k0201/TiN_Anaalog_sensor_emulation/hardware/TiN_analog_sensor_emulation_front.png

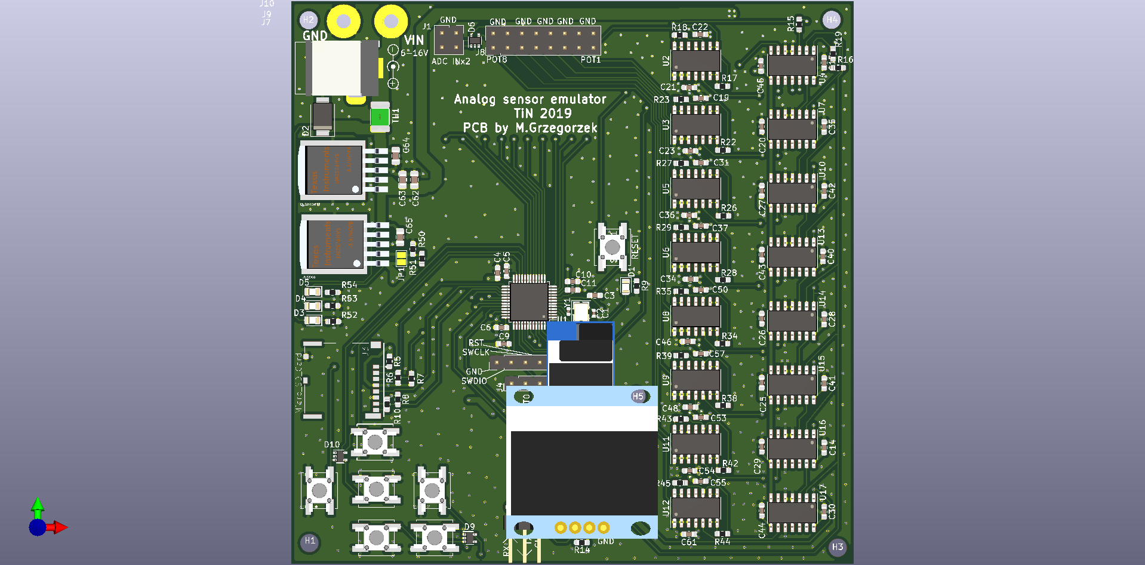
hardware/TiN_analog_sensor_emulation_front.png
