k0201/TiN_Anaalog_sensor_emulation/README.md

# TiN_Anaalog_sensor_emulation
Project for TiN at AGH 2019
