k0201/TiN_Anaalog_sensor_emulation/hardware/TiN_analog_sensor_emulation.pdf

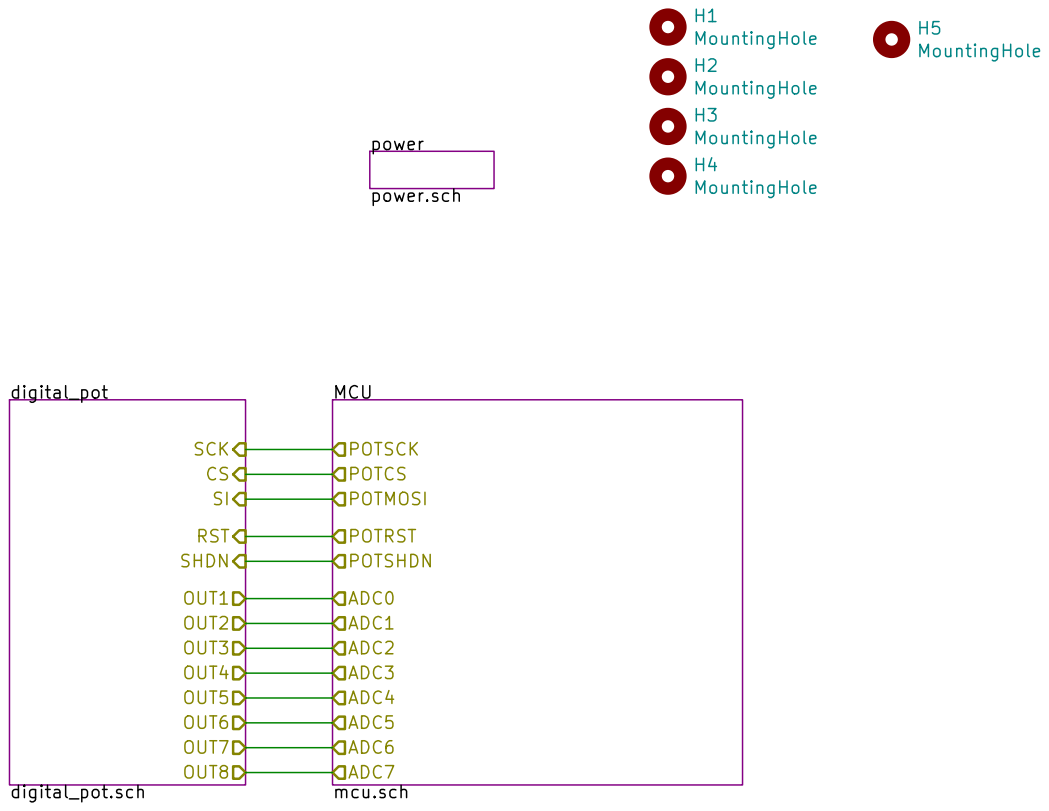
[picture p3: page 1]

MCU mcu.sch POTSCK
ADC0 ADC1 ADC2 ADC3 ADC4 ADC5 ADC7 ADC6 POTRST POTSHDN

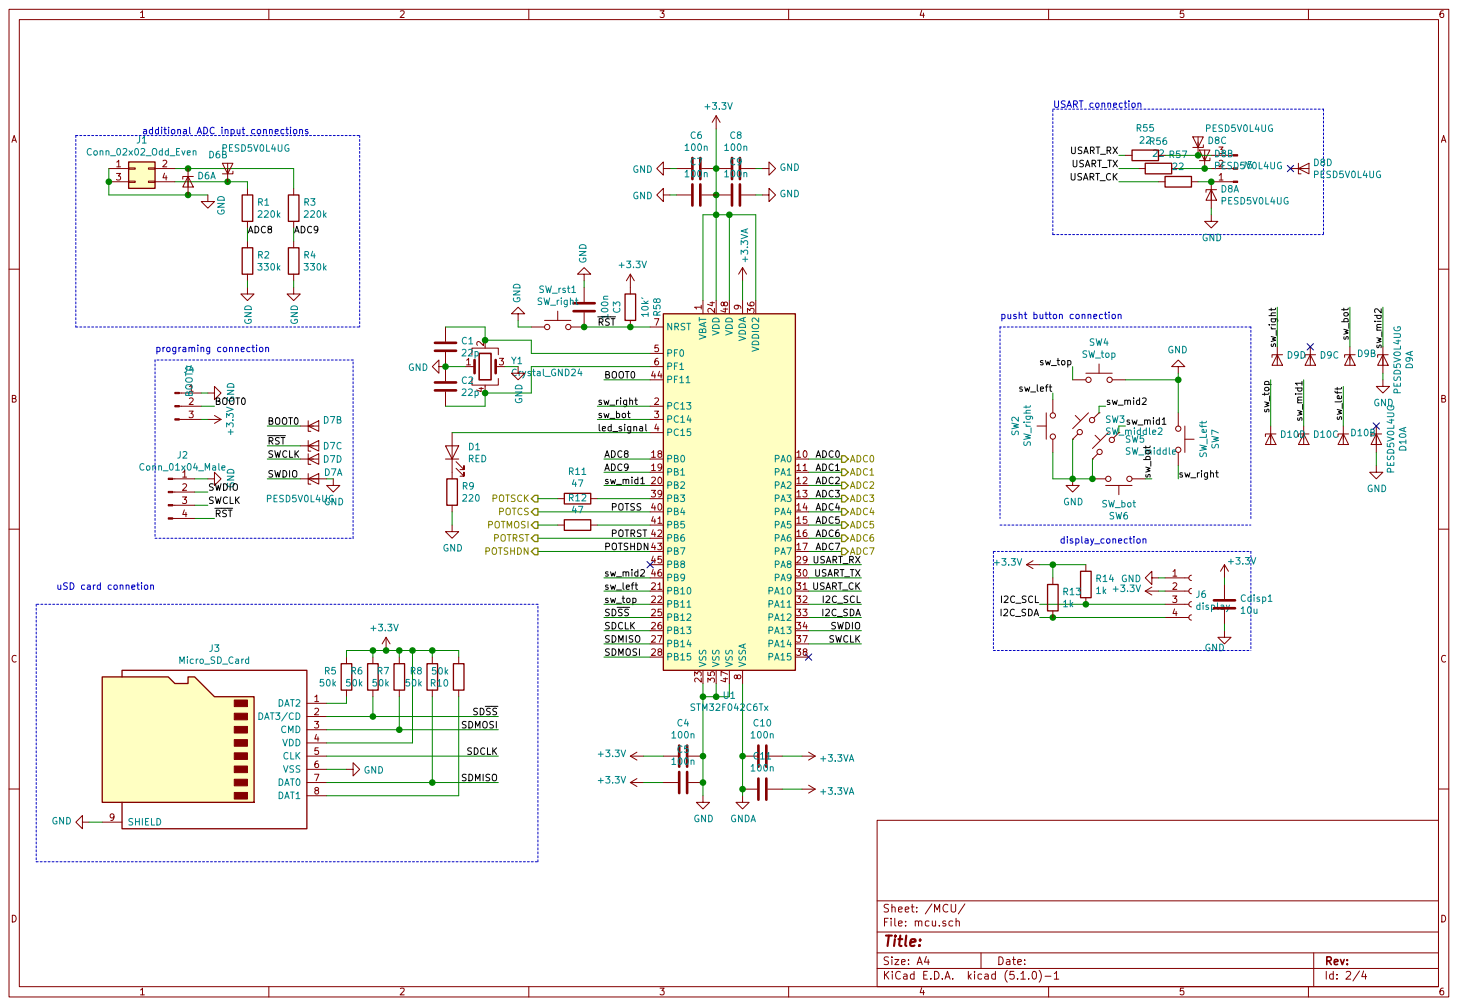
[picture p4: page 2]

additional ADC input connections D6BPESD5V0L4UG GND

9 VDDIO2 36 VSS 23 VSS 35 VSS 47 VSSA

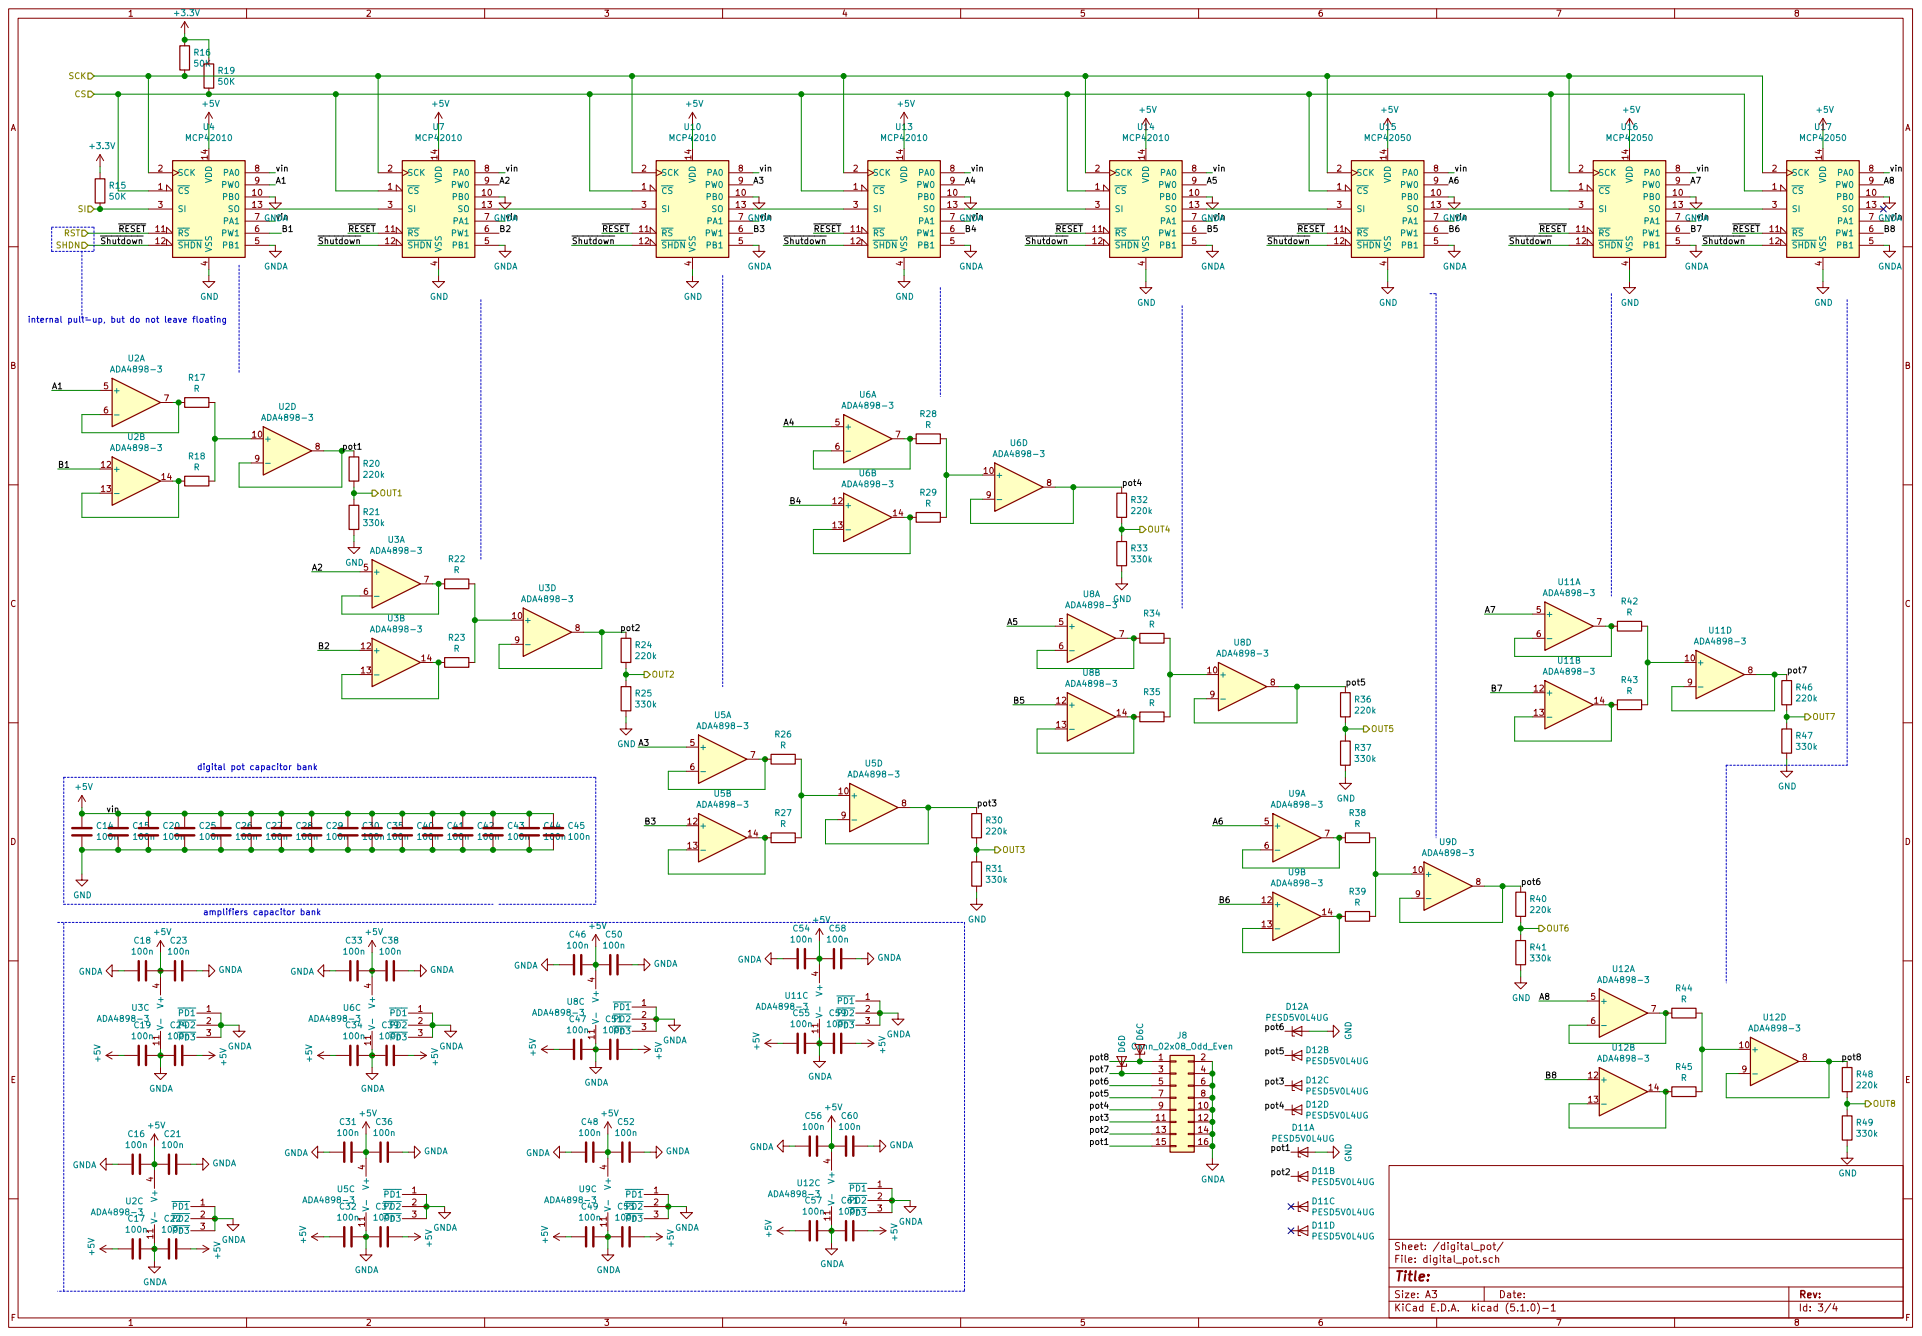
[picture p5: page 3]

4 PB1 5 PW1 6 PA1 7 PA0 8 PW0 9 U4 MCP42010 CS 1 PB0 10 RS 11 SHDN 12 SO 13 VDD 14 SCK 2 SI 3 VSS

4 PB1 5 PW1 6 PA1 7 PA0 8 PW0 9 U7 MCP42010 GND GND GND GND GND

4 PB1 5 PW1 6 PA1 7 PA0 8 PW0 9 U14 MCP42010 CS 1 PB0 10 RS 11 SHDN 12 SO 13 VDD 14 SCK 2 SI 3 VSS

4 PB1 5 PW1 6 PA1 7 PA0 8 PW0 9 U10 MCP42010 CS 1 PB0 10 RS 11 SHDN 12 SO 13 VDD 14 SCK 2 SI 3 VSS

4 PB1 5 PW1 6 PA1 7 PA0 8 PW0 9 U13 MCP42010 CS 1 PB0 10 RS 11 SHDN 12 SO 13 VDD 14 SCK 2 SI 3 VSS

13 VDD 14 SCK
vin B8A8 GNDA GNDA CS

digital pot capacitor bank

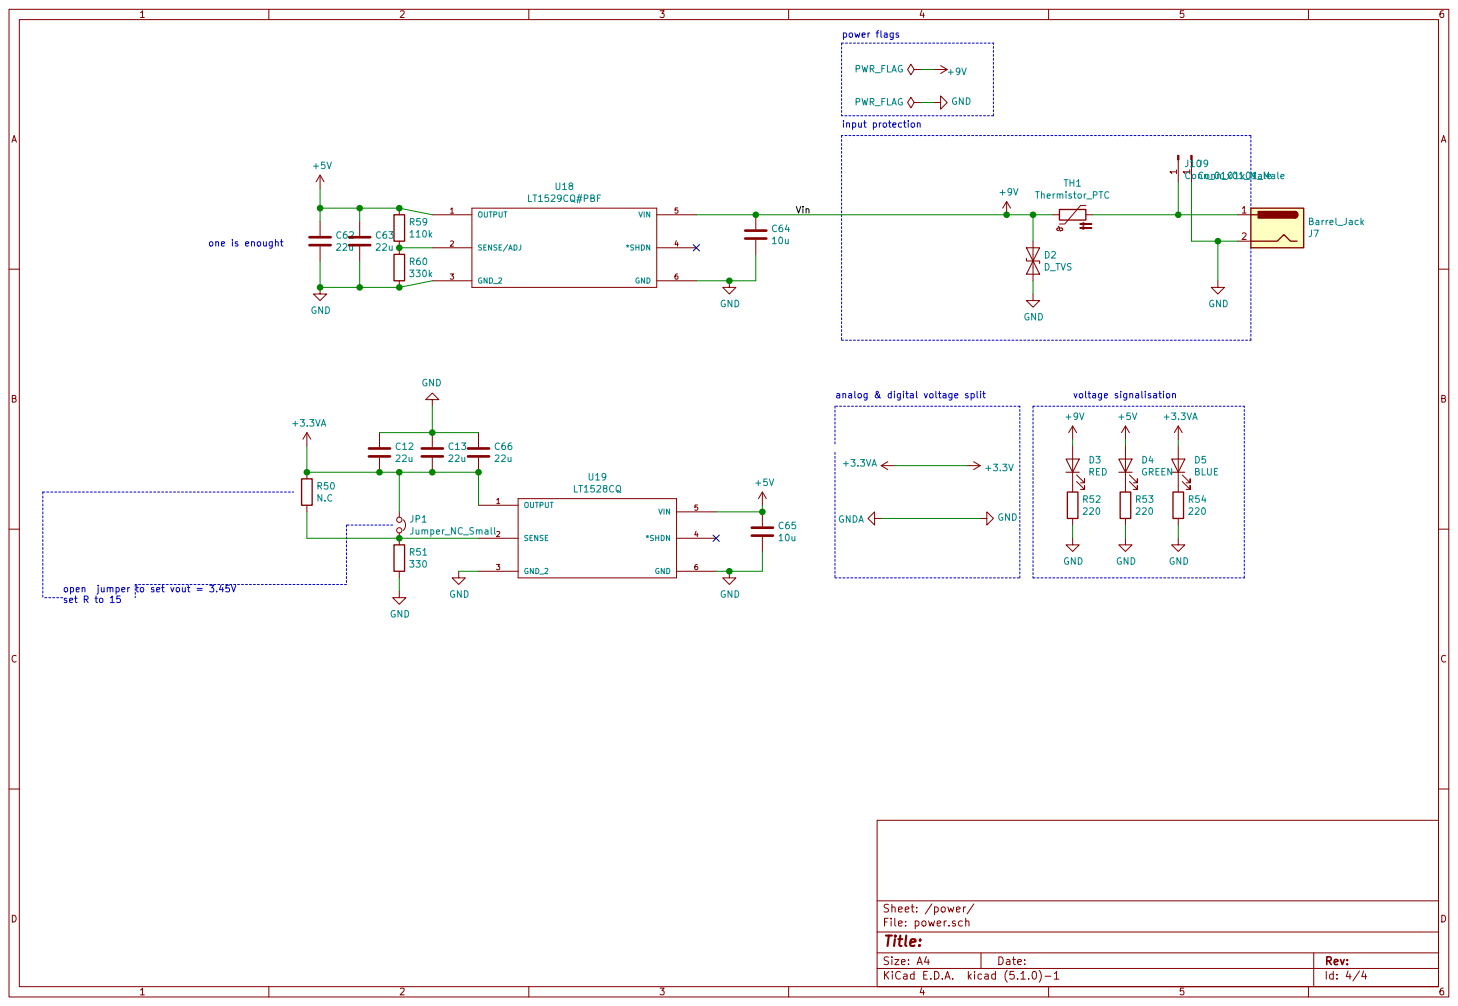
[picture p6: page 4]

open jumper to set vout = 3.45V
