k0201/TiN_Anaalog_sensor_emulation/hardware/simulation_summing_amp.asc

R1: res; {Rd}
R2: res; {Rc}
R3: res; 99k
R4: res; {Rb}
R5: res; {Ra}
R7: res; 10k
R10: res; 1k
U1: AD712
U2: AD712
U3: AD712
V1: voltage; 5
V2: voltage; 5
Named nets: 0, vin, vinm, out
.param Ra=10k*(val/256) Rb= 10k*(1-val/256)
.param Rc=10k*(val/255) Rd=10k*(1-val/256)
.step param val 1 255 1
.op
*.param Ra = 25k Rb = 25k
