k0201/TiN_Anaalog_sensor_emulation/hardware/TiN_analog_sensor_emulation.kicad_pcb

## KiCad design hardware/TiN_analog_sensor_emulation.kicad_pcb (2019-06-26)

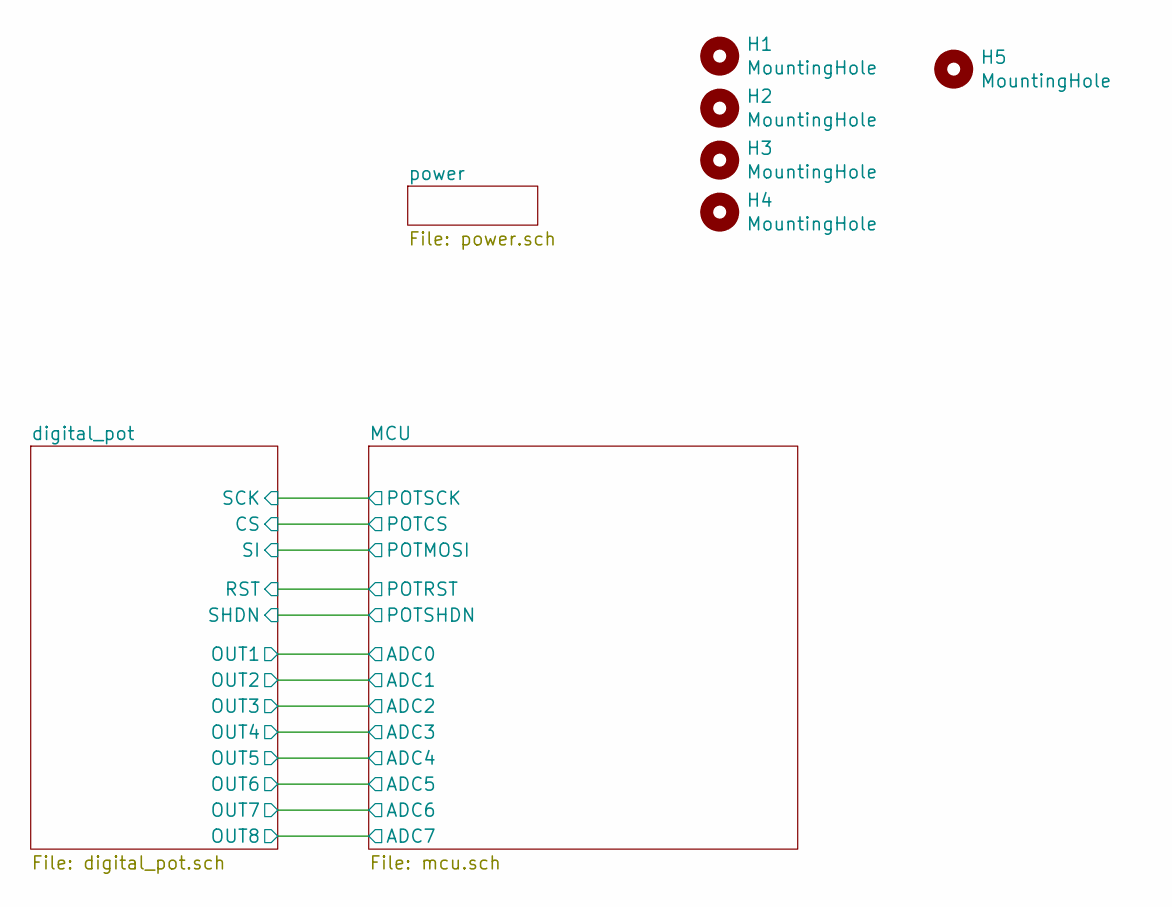
[picture p7: schematic TiN_analog_sensor_emulation.sch]

Parts:
H1, H2, H3, H4, H5: MountingHole; MountingHole_3.2mm_M3

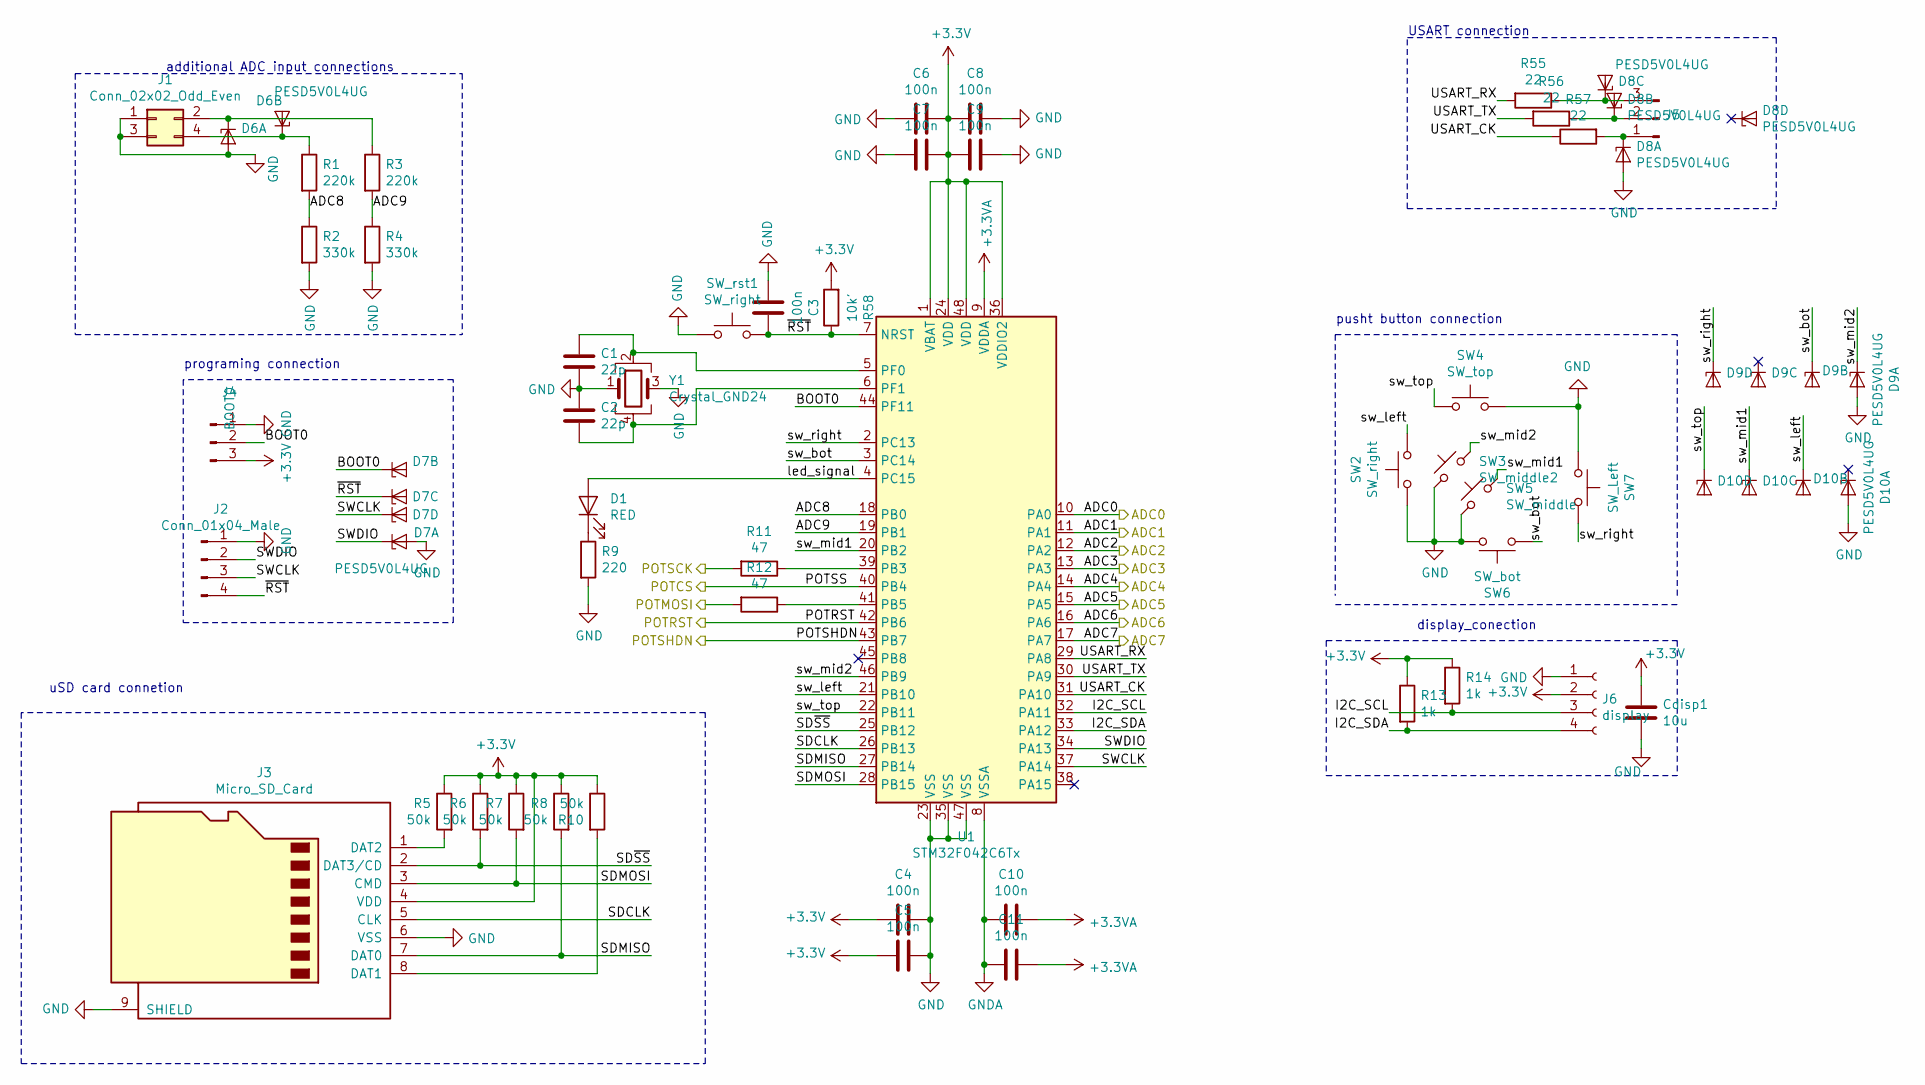
[picture p8: schematic mcu.sch]

Parts:
C1, C2: 22p; C_0402_1005Metric
C3, C4, C5, C6, C7, C8, C9, C10, C11: 100n; C_0603_1608Metric_Pad1.05x0.95mm_HandSolder
Cdisp1: 10u; C_0805_2012Metric
D1: RED; LED_0805_2012Metric
D6, D7, D8, D9, D10: PESD5V0L4UG; SOT-353_SC-70-5
J1: Conn_02x02_Odd_Even; PinHeader_2x02_P2.54mm_Vertical
J2: Conn_01x04_Male; PinHeader_1x04_P2.54mm_Vertical
J3: Micro_SD_Card; MOLEX_503398-1892
J4: BOOT0; PinHeader_1x03_P2.54mm_Vertical
J5: Conn_01x03_Male; PinHeader_1x03_P2.54mm_Horizontal
J6: display; PinSocket_1x04_P2.54mm_Vertical
R1, R3: 220k; R_0603_1608Metric_Pad1.05x0.95mm_HandSolder
R2, R4: 330k; R_0603_1608Metric_Pad1.05x0.95mm_HandSolder
R5, R6, R7, R8, R10: 50k; R_0603_1608Metric_Pad1.05x0.95mm_HandSolder
R9: 220; R_0603_1608Metric_Pad1.05x0.95mm_HandSolder
R11, R12: 47; R_0603_1608Metric_Pad1.05x0.95mm_HandSolder
R13, R14: 1k; R_0603_1608Metric_Pad1.05x0.95mm_HandSolder
R55, R56, R57: 22; R_0603_1608Metric_Pad1.05x0.95mm_HandSolder
R58: 10k'; R_0603_1608Metric_Pad1.05x0.95mm_HandSolder
SW2: SW_right; SW_Push_1P1T_NO_CK_KSC6xxJ
SW3: SW_middle2; SW_Push_1P1T_NO_CK_KSC6xxJ
SW4: SW_top; SW_Push_1P1T_NO_CK_KSC6xxJ
SW5: SW_middle; SW_Push_1P1T_NO_CK_KSC6xxJ
SW6: SW_bot; SW_Push_1P1T_NO_CK_KSC6xxJ
SW7: SW_Left; SW_Push_1P1T_NO_CK_KSC6xxJ
SW_rst1: SW_right; SW_Push_1P1T_NO_CK_KSC6xxJ
U1: STM32F042C6Tx; LQFP-48_7x7mm_P0.5mm
Y1: Crystal_GND24; Crystal_SMD_3225-4Pin_3.2x2.5mm

Connections:
+3.3VA: C4.2, C5.2, C6.1, C7.1, C8.2, C9.2, C10.1, C11.1, Cdisp1.1, J3.4 (VDD), J4.3, J6.2, R5.1, R6.1, R7.1, R8.1, R10.1, R13.1, R14.1, R58.2, U1.1 (VBAT), U1.9 (VDDA), U1.24 (VDD), U1.36 (VDDIO2), U1.48 (VDD); also elsewhere on the board
/MCU/ADC0: U1.10 (PA0); also elsewhere on the board
/MCU/ADC1: U1.11 (PA1); also elsewhere on the board
/MCU/ADC2: U1.12 (PA2); also elsewhere on the board
/MCU/ADC3: U1.13 (PA3); also elsewhere on the board
/MCU/ADC4: U1.14 (PA4); also elsewhere on the board
/MCU/ADC5: U1.15 (PA5); also elsewhere on the board
/MCU/ADC6: U1.16 (PA6); also elsewhere on the board
/MCU/ADC7: U1.17 (PA7); also elsewhere on the board
/MCU/ADC8: R1.2, R2.1, U1.18 (PB0)
/MCU/ADC9: R3.2, R4.1, U1.19 (PB1)
/MCU/BOOT0: D7.3 (K2), J4.2, U1.44 (PF11)
/MCU/I2C_SCL: J6.3, R14.2, U1.32 (PA11)
/MCU/I2C_SDA: J6.4, R13.2, U1.33 (PA12)
/MCU/POTMOSI: R12.2; also elsewhere on the board
/MCU/POTRST: U1.42 (PB6); also elsewhere on the board
/MCU/POTSCK: R11.2; also elsewhere on the board
/MCU/POTSHDN: U1.43 (PB7); also elsewhere on the board
/MCU/SDCLK: J3.5 (CLK), U1.26 (PB13)
/MCU/SDMISO: J3.7 (DAT0), R8.2, U1.27 (PB14)
/MCU/SDMOSI: J3.3 (CMD), R7.2, U1.28 (PB15)
/MCU/SD~SS: J3.2 (DAT3/CD), R6.2, U1.25 (PB12)
/MCU/SWCLK: D7.5 (K4), J2.3, U1.37 (PA14)
/MCU/SWDIO: D7.1 (K1), J2.2, U1.34 (PA13)
/MCU/USART_CK: R57.1, U1.31 (PA10)
/MCU/USART_RX: R55.2, U1.29 (PA8)
/MCU/USART_TX: R56.2, U1.30 (PA9)
/MCU/led_signal: D1.2 (A), U1.4 (PC15)
/MCU/sw_bot: D9.3 (K2), SW6.1, U1.3 (PC14)
/MCU/sw_left: D10.3 (K2), SW2.2, U1.21 (PB10)
/MCU/sw_mid1: D10.4 (K3), SW5.2, U1.20 (PB2)
/MCU/sw_mid2: D9.1 (K1), SW3.2, U1.46 (PB9)
/MCU/sw_right: D9.5 (K4), SW7.2, U1.2 (PC13)
/MCU/sw_top: D10.5 (K4), SW4.1, U1.22 (PB11)
/MCU/~RST: C3.1, D7.4 (K3), J2.4, R58.1, SW_rst1.2, U1.7 (NRST)
/digital_pot/CS: U1.40 (PB4); also elsewhere on the board
GND: C1.2, C2.1, C3.2, C4.1, C5.1, C6.2, C7.2, C8.1, C9.1, C10.2, C11.2, Cdisp1.2, D6.2 (A), D7.2 (A), D8.2 (A), D9.2 (A), D10.2 (A), J1.1, J1.3, J2.1, J3.6 (VSS), J3.9 (SHIELD), J4.1, J6.1, R2.2, R4.2, R9.2, SW2.1, SW3.1, SW4.2, SW5.1, SW6.2, SW7.1, SW_rst1.1, U1.8 (VSSA), U1.23 (VSS), U1.35 (VSS), U1.47 (VSS), Y1.1, Y1.3; also elsewhere on the board
unnamed: C1.1, U1.5 (PF0), Y1.2
unnamed: C2.2, U1.6 (PF1), Y1.4
unnamed: D1.1 (K), R9.1
unnamed: D6.1 (K1), J1.2, R3.1
unnamed: D6.3 (K2), J1.4, R1.1
unnamed: D8.1 (K1), J5.1, R57.2
unnamed: D8.3 (K2), J5.2, R56.1
unnamed: D8.4 (K3), J5.3, R55.1
unnamed: J3.1 (DAT2), R5.2
unnamed: J3.8 (DAT1), R10.2
unnamed: R11.1, U1.39 (PB3)
unnamed: R12.1, U1.41 (PB5)

Notes on the sheet:
display_conection
pusht button connection
uSD card connetion
programing connection
USART connection
additional ADC input connections

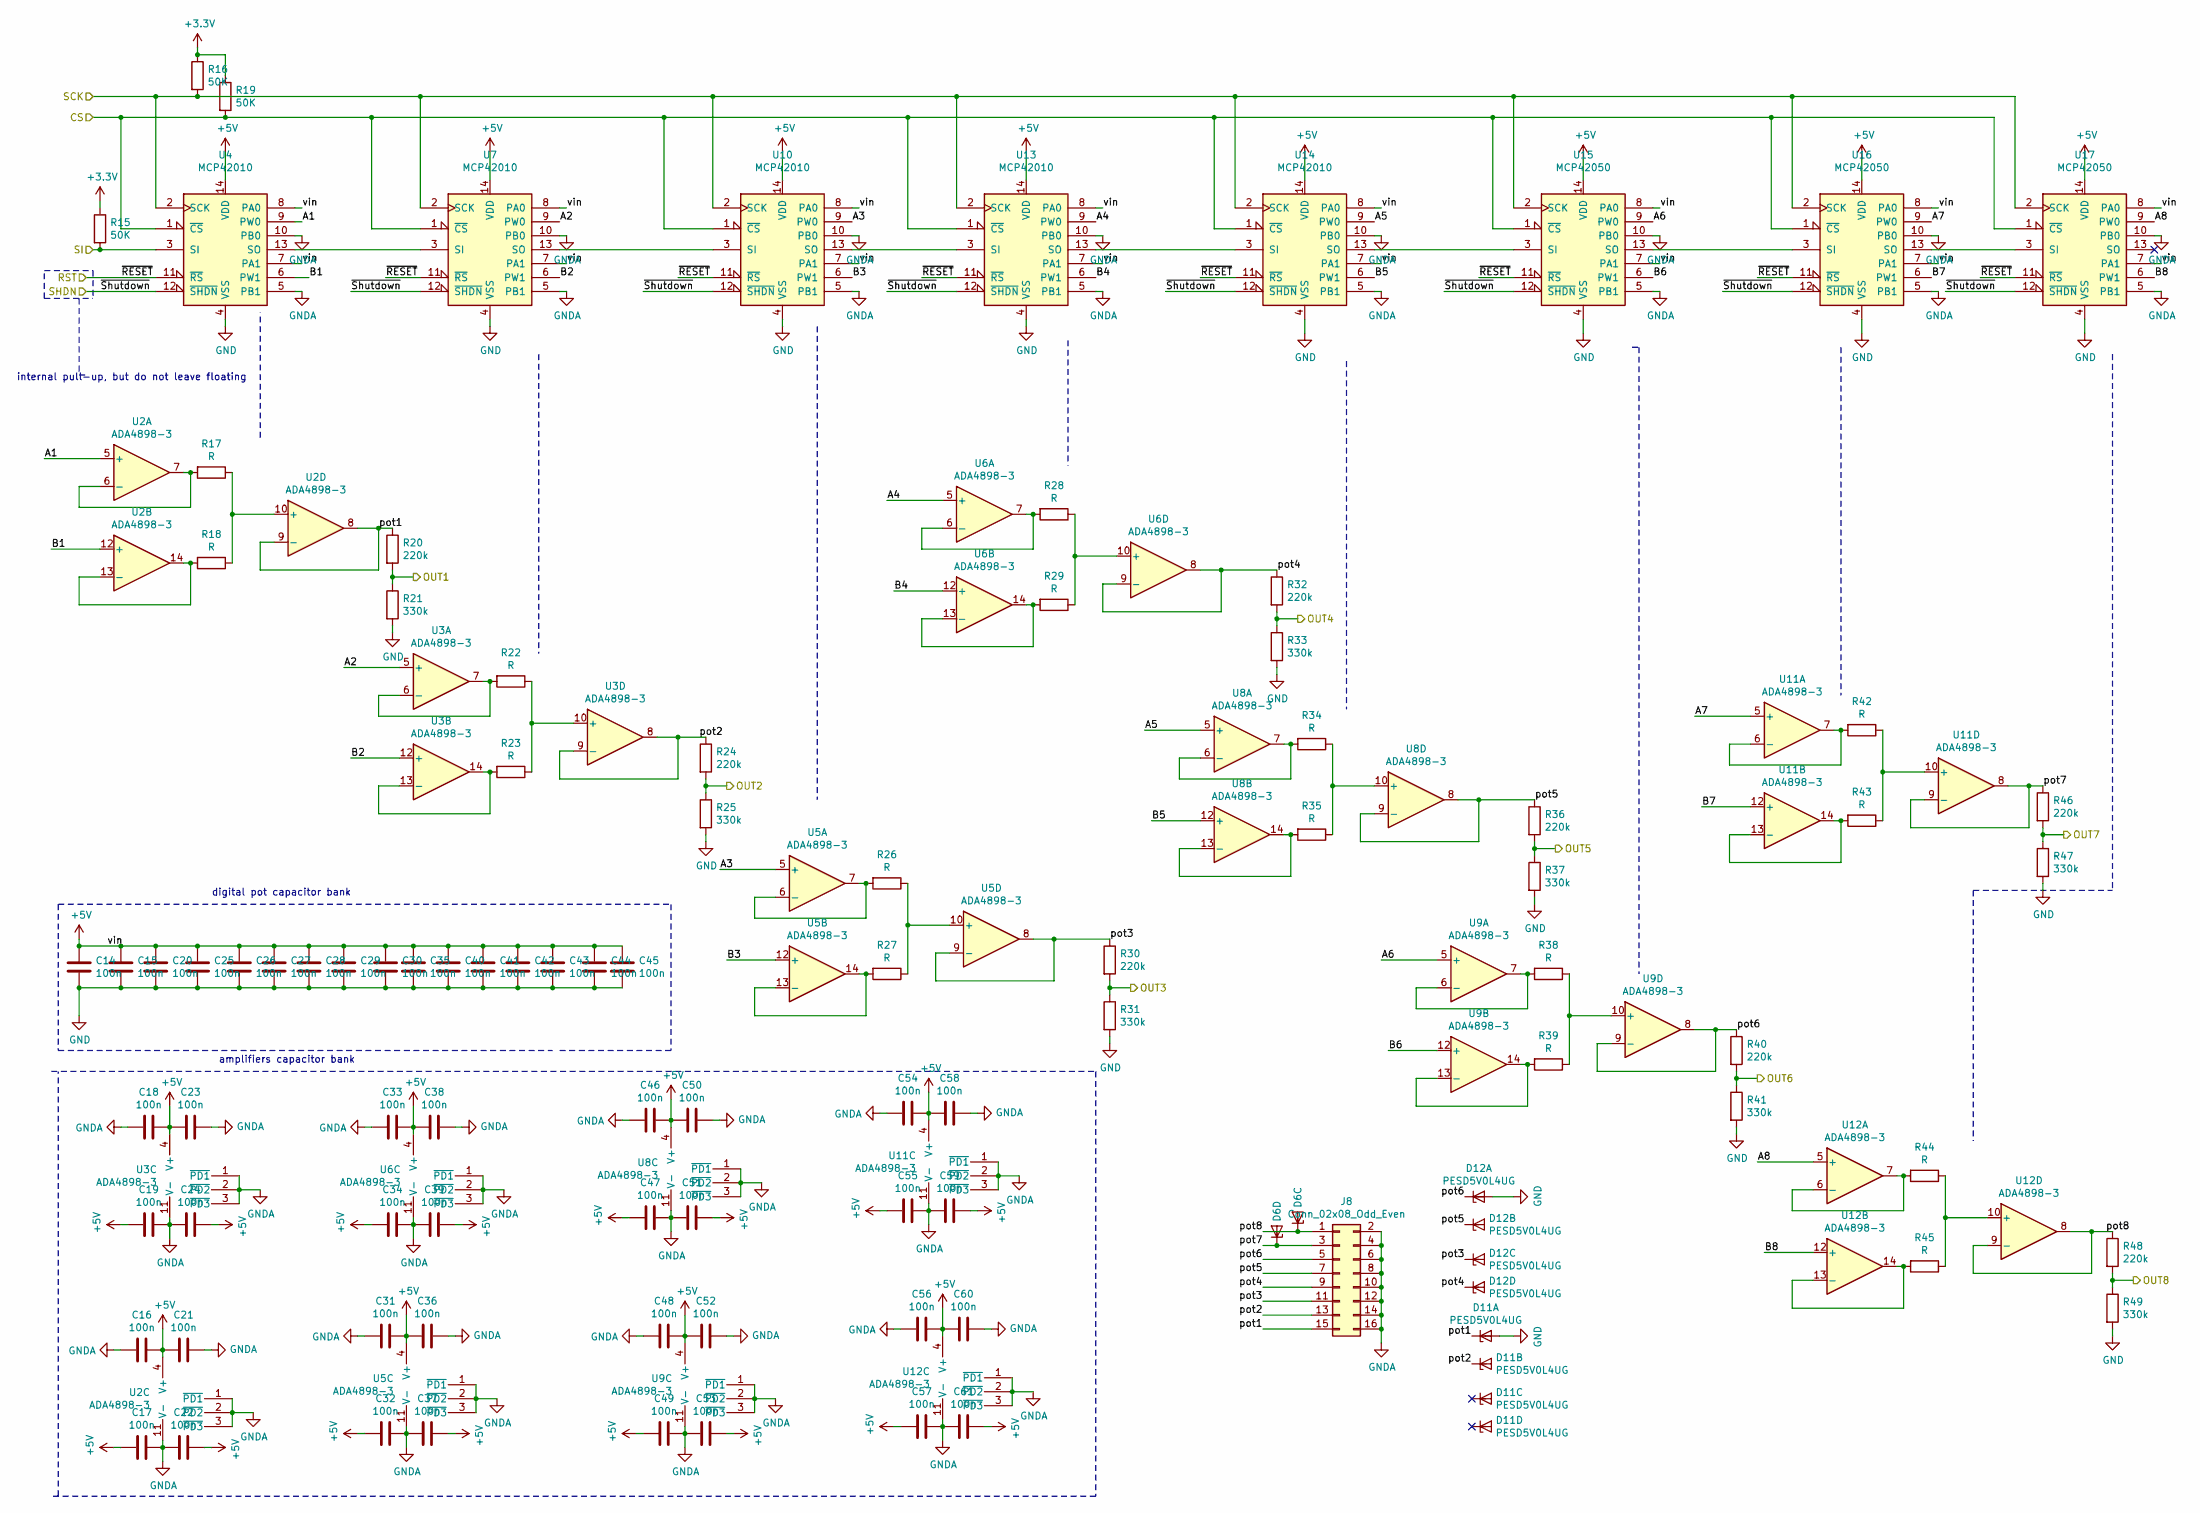
[picture p9: schematic digital_pot.sch]

Parts:
C14, C15, C16, C17, C18, C19, C20, C21, C22, C23, C24, C25, C26, C27, C28, C29, C30, C31, C32, C33, C34, C35, C36, C37, C38, C39, C40, C41, C42, C43, C44, C45, C46, C47, C48, C49, C50, C51, C52, C53, C54, C55, C56, C57, C58, C59, C60, C61: 100n; C_0603_1608Metric_Pad1.05x0.95mm_HandSolder
D6, D11, D12: PESD5V0L4UG; SOT-353_SC-70-5
J8: Conn_02x08_Odd_Even; PinHeader_2x08_P2.54mm_Vertical
R15, R16, R19: 50K; R_0603_1608Metric_Pad1.05x0.95mm_HandSolder
R17, R18, R22, R23, R26, R27, R28, R29, R34, R35, R38, R39, R42, R43, R44, R45: R; R_0603_1608Metric_Pad1.05x0.95mm_HandSolder
R20, R24, R30, R32, R36, R40, R46, R48: 220k; R_0603_1608Metric_Pad1.05x0.95mm_HandSolder
R21, R25, R31, R33, R37, R41, R47, R49: 330k; R_0603_1608Metric_Pad1.05x0.95mm_HandSolder
U2, U3, U5, U6, U8, U9, U11, U12: ADA4898-3; SOIC-14_3.9x8.7mm_P1.27mm
U4, U7, U10, U13, U14: MCP42010; SOIC-14_3.9x8.7mm_P1.27mm
U15, U16, U17: MCP42050; SOIC-14_3.9x8.7mm_P1.27mm

Connections:
+3.3VA: R15.1, R16.1, R19.1; also elsewhere on the board
+5V: C14.2, C15.2, C16.1, C17.2, C18.1, C19.2, C20.2, C21.2, C22.1, C23.2, C24.1, C25.2, C26.2, C27.2, C28.2, C29.2, C30.2, C31.1, C32.2, C33.1, C34.2, C35.2, C36.2, C37.1, C38.2, C39.1, C40.2, C41.2, C42.2, C43.2, C44.2, C45.2, C46.1, C47.2, C48.1, C49.2, C50.2, C51.1, C52.2, C53.1, C54.1, C55.2, C56.1, C57.2, C58.2, C59.1, C60.2, C61.1, U2.4 (V+), U3.4 (V+), U4.7 (PA1), U4.8 (PA0), U4.14 (VDD), U5.4 (V+), U6.4 (V+), U7.7 (PA1), U7.8 (PA0), U7.14 (VDD), U8.4 (V+), U9.4 (V+), U10.7 (PA1), U10.8 (PA0), U10.14 (VDD), U11.4 (V+), U12.4 (V+), U13.7 (PA1), U13.8 (PA0), U13.14 (VDD), U14.7 (PA1), U14.8 (PA0), U14.14 (VDD), U15.7 (PA1), U15.8 (PA0), U15.14 (VDD), U16.7 (PA1), U16.8 (PA0), U16.14 (VDD), U17.7 (PA1), U17.8 (PA0), U17.14 (VDD); also elsewhere on the board
/MCU/ADC0: R20.2, R21.1; also elsewhere on the board
/MCU/ADC1: R24.2, R25.1; also elsewhere on the board
/MCU/ADC2: R30.2, R31.1; also elsewhere on the board
/MCU/ADC3: R32.2, R33.1; also elsewhere on the board
/MCU/ADC4: R36.2, R37.1; also elsewhere on the board
/MCU/ADC5: R40.2, R41.1; also elsewhere on the board
/MCU/ADC6: R46.2, R47.1; also elsewhere on the board
/MCU/ADC7: R48.2, R49.1; also elsewhere on the board
/MCU/POTMOSI: R15.2, U4.3 (SI); also elsewhere on the board
/MCU/POTRST: U4.11 (~RS), U7.11 (~RS), U10.11 (~RS), U13.11 (~RS), U14.11 (~RS), U15.11 (~RS), U16.11 (~RS), U17.11 (~RS); also elsewhere on the board
/MCU/POTSCK: R16.2, U4.2 (SCK), U7.2 (SCK), U10.2 (SCK), U13.2 (SCK), U14.2 (SCK), U15.2 (SCK), U16.2 (SCK), U17.2 (SCK); also elsewhere on the board
/MCU/POTSHDN: U4.12 (~SHDN), U7.12 (~SHDN), U10.12 (~SHDN), U13.12 (~SHDN), U14.12 (~SHDN), U15.12 (~SHDN), U16.12 (~SHDN), U17.12 (~SHDN); also elsewhere on the board
/digital_pot/A1: U2.5 (+), U4.9 (PW0)
/digital_pot/A2: U3.5 (+), U7.9 (PW0)
/digital_pot/A3: U5.5 (+), U10.9 (PW0)
/digital_pot/A4: U6.5 (+), U13.9 (PW0)
/digital_pot/A5: U8.5 (+), U14.9 (PW0)
/digital_pot/A6: U9.5 (+), U15.9 (PW0)
/digital_pot/A7: U11.5 (+), U16.9 (PW0)
/digital_pot/A8: U12.5 (+), U17.9 (PW0)
/digital_pot/B1: U2.12 (+), U4.6 (PW1)
/digital_pot/B2: U3.12 (+), U7.6 (PW1)
/digital_pot/B3: U5.12 (+), U10.6 (PW1)
/digital_pot/B4: U6.12 (+), U13.6 (PW1)
/digital_pot/B5: U8.12 (+), U14.6 (PW1)
/digital_pot/B6: U9.12 (+), U15.6 (PW1)
/digital_pot/B7: U11.12 (+), U16.6 (PW1)
/digital_pot/B8: U12.12 (+), U17.6 (PW1)
/digital_pot/CS: R19.2, U4.1 (~CS), U7.1 (~CS), U10.1 (~CS), U13.1 (~CS), U14.1 (~CS), U15.1 (~CS), U16.1 (~CS), U17.1 (~CS); also elsewhere on the board
/digital_pot/pot1: D11.1 (K1), J8.15, R20.1, U2.8, U2.9 (-)
/digital_pot/pot2: D11.3 (K2), J8.13, R24.1, U3.8, U3.9 (-)
/digital_pot/pot3: D12.4 (K3), J8.11, R30.1, U5.8, U5.9 (-)
/digital_pot/pot4: D12.5 (K4), J8.9, R32.1, U6.8, U6.9 (-)
/digital_pot/pot5: D12.3 (K2), J8.7, R36.1, U8.8, U8.9 (-)
/digital_pot/pot6: D12.1 (K1), J8.5, R40.1, U9.8, U9.9 (-)
/digital_pot/pot7: D6.5 (K4), J8.3, R46.1, U11.8, U11.9 (-)
/digital_pot/pot8: D6.4 (K3), J8.1, R48.1, U12.8, U12.9 (-)
GND: C14.1, C15.1, C16.2, C17.1, C18.2, C19.1, C20.1, C21.1, C22.2, C23.1, C24.2, C25.1, C26.1, C27.1, C28.1, C29.1, C30.1, C31.2, C32.1, C33.2, C34.1, C35.1, C36.1, C37.2, C38.1, C39.2, C40.1, C41.1, C42.1, C43.1, C44.1, C45.1, C46.2, C47.1, C48.2, C49.1, C50.1, C51.2, C52.1, C53.2, C54.2, C55.1, C56.2, C57.1, C58.1, C59.2, C60.1, C61.2, D11.2 (A), D12.2 (A), J8.2, J8.4, J8.6, J8.8, J8.10, J8.12, J8.14, J8.16, R21.2, R25.2, R31.2, R33.2, R37.2, R41.2, R47.2, R49.2, U2.1 (~PD1), U2.2 (~PD2), U2.3 (~PD3), U2.11 (V-), U3.1 (~PD1), U3.2 (~PD2), U3.3 (~PD3), U3.11 (V-), U4.4 (VSS), U4.5 (PB1), U4.10 (PB0), U5.1 (~PD1), U5.2 (~PD2), U5.3 (~PD3), U5.11 (V-), U6.1 (~PD1), U6.2 (~PD2), U6.3 (~PD3), U6.11 (V-), U7.4 (VSS), U7.5 (PB1), U7.10 (PB0), U8.1 (~PD1), U8.2 (~PD2), U8.3 (~PD3), U8.11 (V-), U9.1 (~PD1), U9.2 (~PD2), U9.3 (~PD3), U9.11 (V-), U10.4 (VSS), U10.5 (PB1), U10.10 (PB0), U11.1 (~PD1), U11.2 (~PD2), U11.3 (~PD3), U11.11 (V-), U12.1 (~PD1), U12.2 (~PD2), U12.3 (~PD3), U12.11 (V-), U13.4 (VSS), U13.5 (PB1), U13.10 (PB0), U14.4 (VSS), U14.5 (PB1), U14.10 (PB0), U15.4 (VSS), U15.5 (PB1), U15.10 (PB0), U16.4 (VSS), U16.5 (PB1), U16.10 (PB0), U17.4 (VSS), U17.5 (PB1), U17.10 (PB0); also elsewhere on the board
unnamed: R17.1, R18.1, U2.10 (+)
unnamed: R17.2, U2.6 (-), U2.7
unnamed: R18.2, U2.13 (-), U2.14
unnamed: R22.1, R23.1, U3.10 (+)
unnamed: R22.2, U3.6 (-), U3.7
unnamed: R23.2, U3.13 (-), U3.14
unnamed: R26.1, R27.1, U5.10 (+)
unnamed: R26.2, U5.6 (-), U5.7
unnamed: R27.2, U5.13 (-), U5.14
unnamed: R28.1, R29.1, U6.10 (+)
unnamed: R28.2, U6.6 (-), U6.7
unnamed: R29.2, U6.13 (-), U6.14
unnamed: R34.1, R35.1, U8.10 (+)
unnamed: R34.2, U8.6 (-), U8.7
unnamed: R35.2, U8.13 (-), U8.14
unnamed: R38.1, R39.1, U9.10 (+)
unnamed: R38.2, U9.6 (-), U9.7
unnamed: R39.2, U9.13 (-), U9.14
unnamed: R42.1, R43.1, U11.10 (+)
unnamed: R42.2, U11.6 (-), U11.7
unnamed: R43.2, U11.13 (-), U11.14
unnamed: R44.1, R45.1, U12.10 (+)
unnamed: R44.2, U12.6 (-), U12.7
unnamed: R45.2, U12.13 (-), U12.14
unnamed: U4.13 (SO), U7.3 (SI)
unnamed: U7.13 (SO), U10.3 (SI)
unnamed: U10.13 (SO), U13.3 (SI)
unnamed: U13.13 (SO), U14.3 (SI)
unnamed: U14.13 (SO), U15.3 (SI)
unnamed: U15.13 (SO), U16.3 (SI)
unnamed: U16.13 (SO), U17.3 (SI)

Notes on the sheet:
internal pull-up, but do not leave floating
digital pot capacitor bank
amplifiers capacitor bank

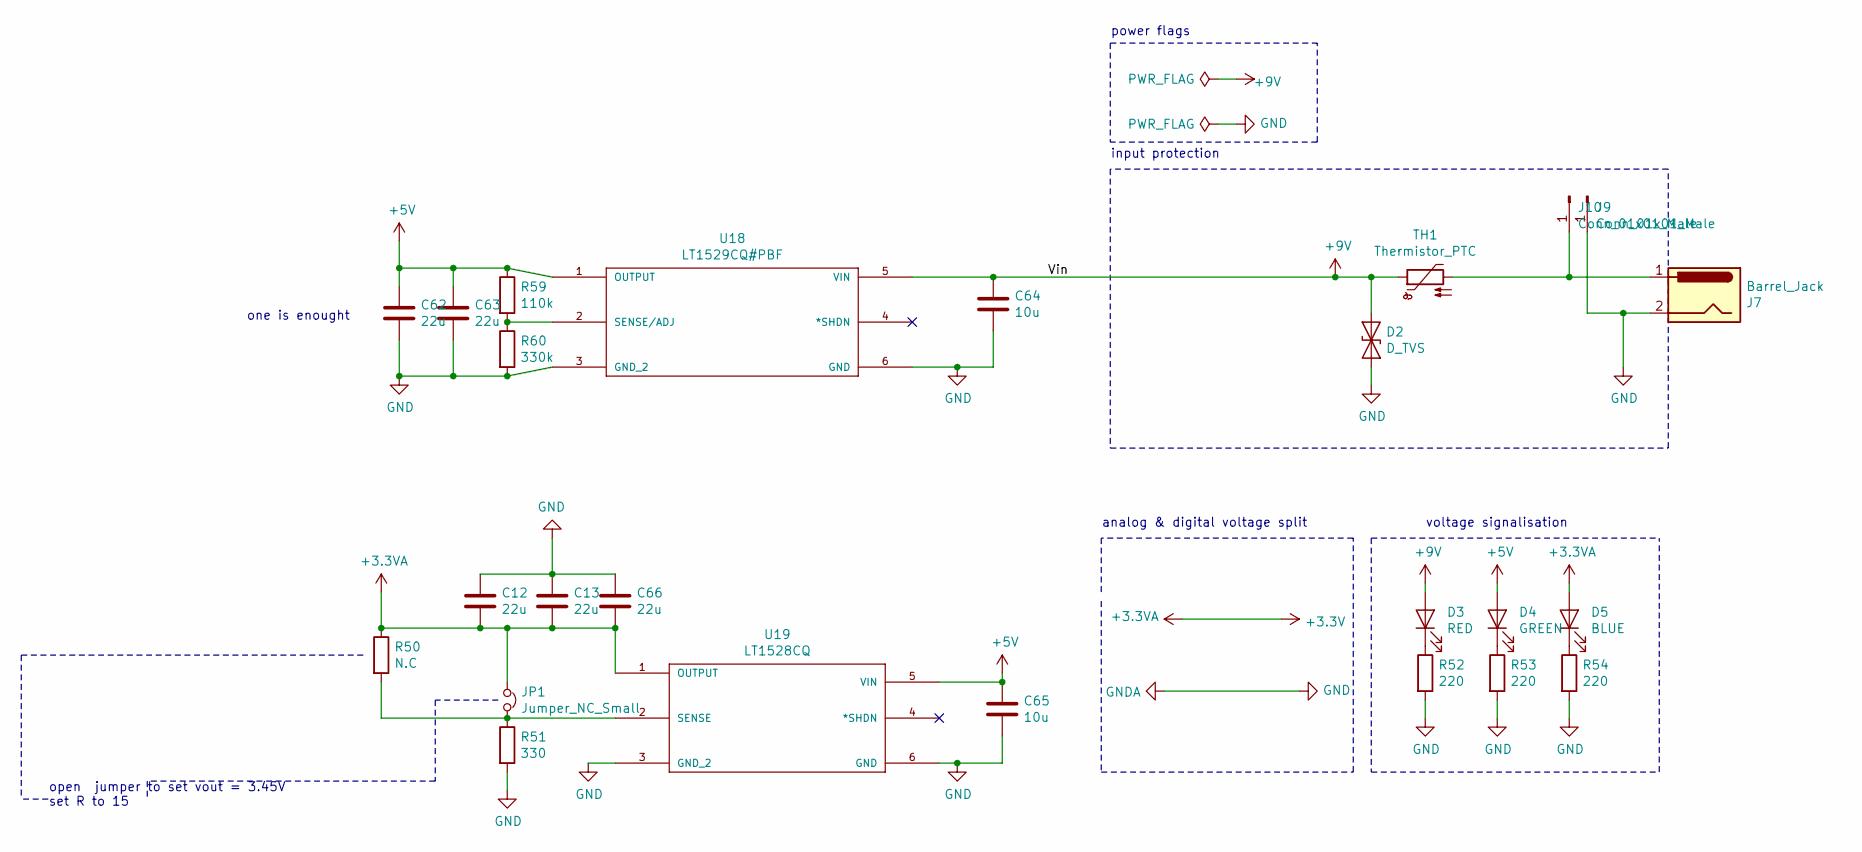
[picture p10: schematic power.sch]

Parts:
C12, C13, C62, C63, C66: 22u; C_0805_2012Metric_Pad1.15x1.40mm_HandSolder
C64, C65: 10u; C_0805_2012Metric_Pad1.15x1.40mm_HandSolder
D2: D_TVS; D_SMB
D3: RED; LED_0805_2012Metric
D4: GREEN; LED_0805_2012Metric
D5: BLUE; LED_0805_2012Metric
J7: Barrel_Jack; BarrelJack_Horizontal
J9, J10: Conn_01x01_Male; SolderWirePad_1x01_Drill2.5mm
JP1: Jumper_NC_Small; SolderJumper-2_P1.3mm_Bridged_Pad1.0x1.5mm
R50: N.C; R_0603_1608Metric_Pad1.05x0.95mm_HandSolder
R51: 330; R_0603_1608Metric_Pad1.05x0.95mm_HandSolder
R52, R53, R54: 220; R_0603_1608Metric_Pad1.05x0.95mm_HandSolder
R59: 110k; R_0603_1608Metric_Pad1.05x0.95mm_HandSolder
R60: 330k; R_0603_1608Metric_Pad1.05x0.95mm_HandSolder
TH1: Thermistor_PTC; Fuse_1812_4532Metric
U18: LT1529CQ#PBF; DDPAK-5_Q
U19: LT1528CQ; DDPAK-5_Q

Connections:
+3.3VA: C12.2, C13.2, C66.2, D5.2 (A), JP1.1, R50.1, U19.1 (OUTPUT); also elsewhere on the board
+5V: C62.1, C63.1, C65.1, D4.2 (A), R59.1, U18.1 (OUTPUT), U19.5 (VIN); also elsewhere on the board
+9V: C64.1, D2.1 (A1), D3.2 (A), TH1.1, U18.5 (VIN)
GND: C12.1, C13.1, C62.2, C63.2, C64.2, C65.2, C66.1, D2.2 (A2), J7.2, J9.1, R51.2, R52.2, R53.2, R54.2, R60.2, U18.3 (GND_2), U18.6 (GND), U19.3 (GND_2), U19.6 (GND); also elsewhere on the board
unnamed: D3.1 (K), R52.1
unnamed: D4.1 (K), R53.1
unnamed: D5.1 (K), R54.1
unnamed: J7.1, J10.1, TH1.2
unnamed: JP1.2, R50.2, R51.1, U19.2 (SENSE)
unnamed: R59.2, R60.1, U18.2 (SENSE/ADJ)

Notes on the sheet:
open jumper to set vout = 3.45V set R to 15
one is enought
input protection
voltage signalisation
analog & digital voltage split
power flags

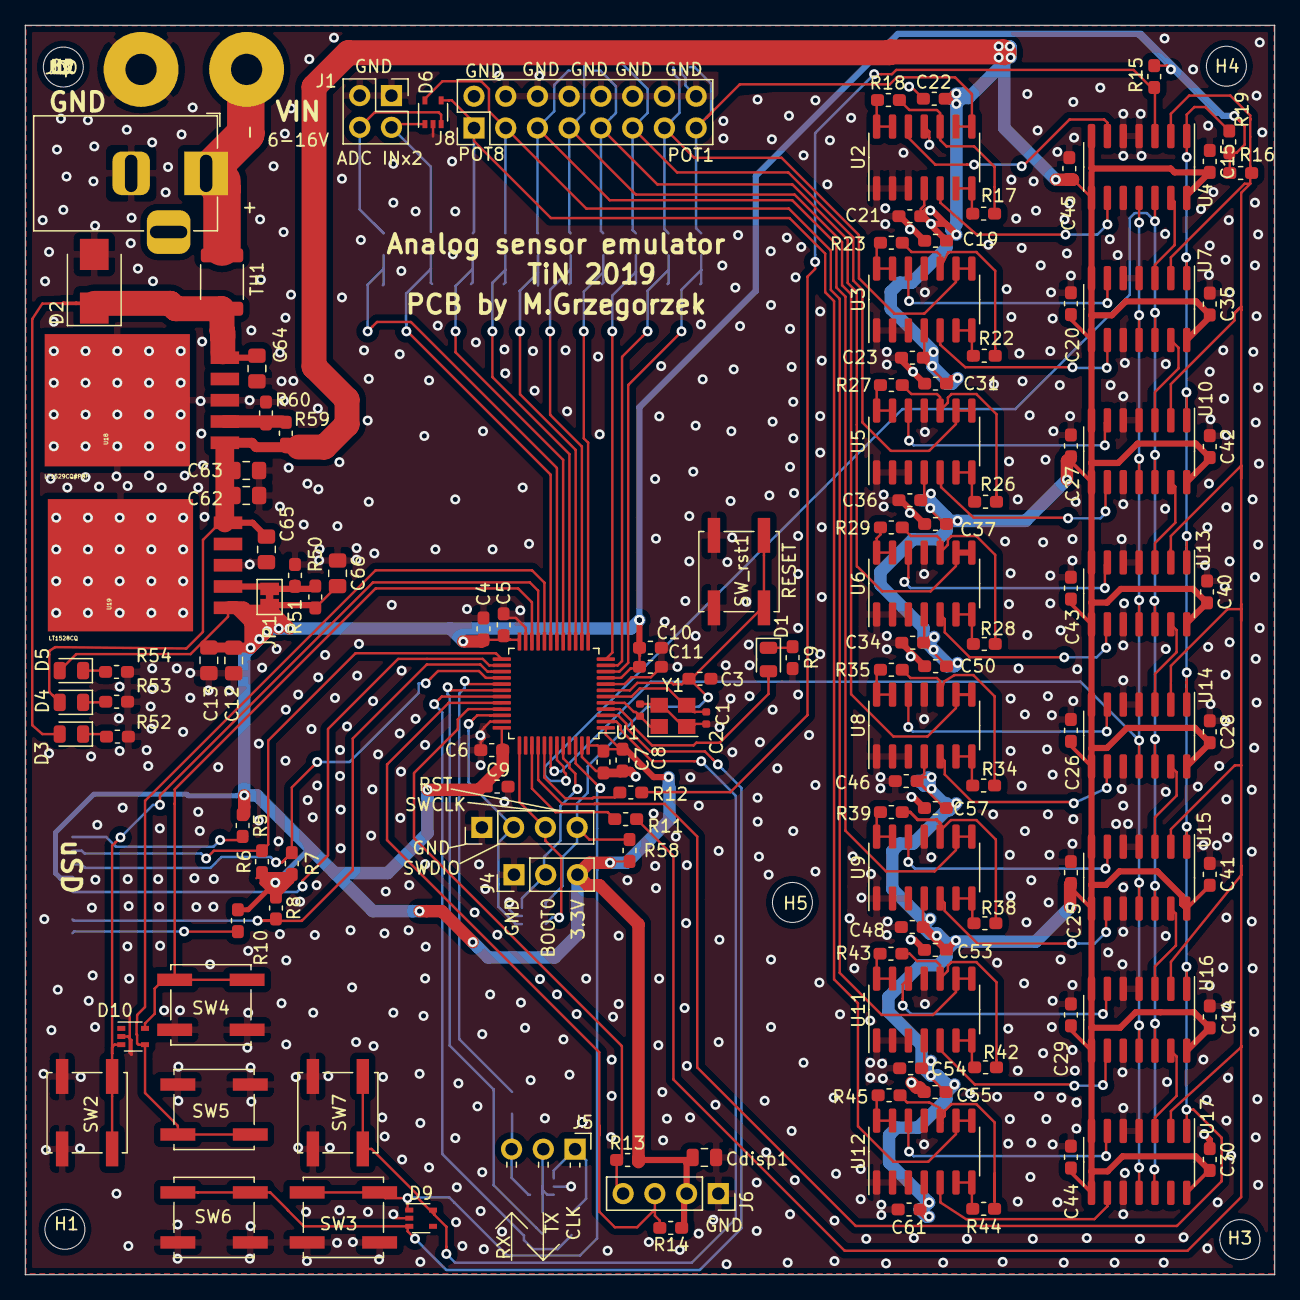
[picture p11: board TiN_analog_sensor_emulation.kicad_pcb from above]

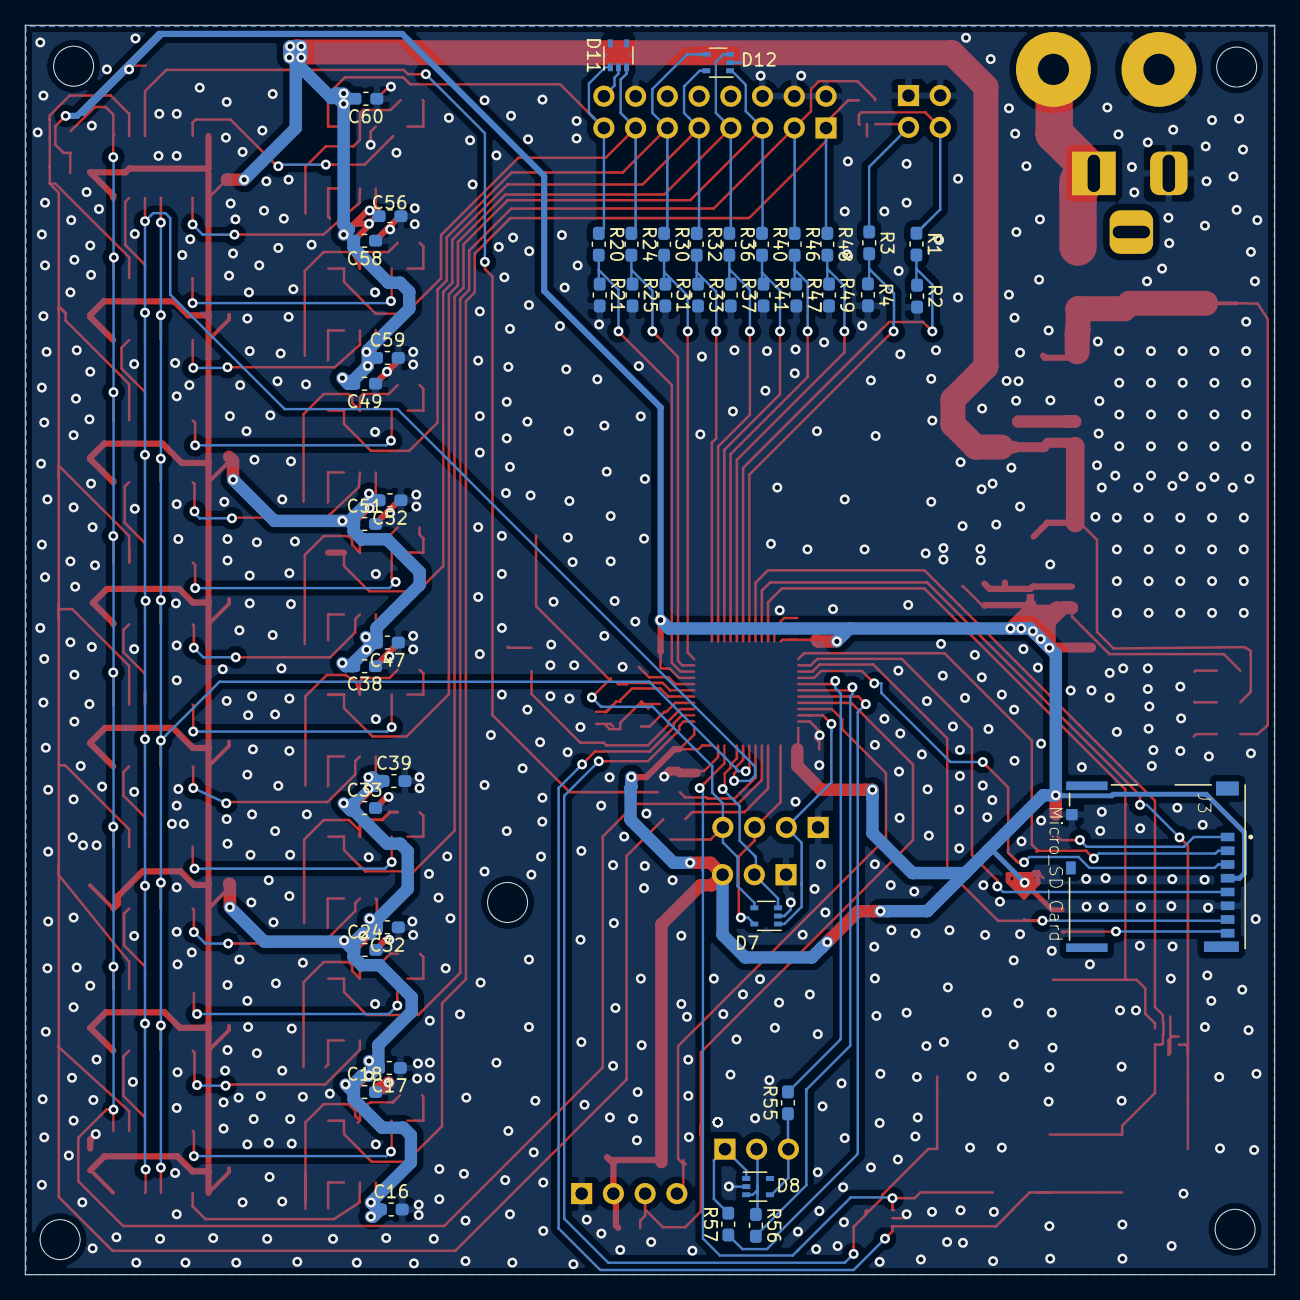
[picture p12: board TiN_analog_sensor_emulation.kicad_pcb from below]

Board: 2 copper layers, 100.0 x 100.0 mm, 183 parts (44 on the bottom side), 112 nets.
