k0201/TiN_Anaalog_sensor_emulation/software/software.ioc

Mcu.UserName=STM32F042C6Tx
PA0.Signal=ADC_IN0
PA1.Signal=ADC_IN1
PA10.Signal=USART1_RX
PA11.Signal=I2C1_SCL
PA12.Signal=I2C1_SDA
PA13.Signal=SYS_SWDIO
PA14.Signal=SYS_SWCLK
PA2.Signal=ADC_IN2
PA3.Signal=ADC_IN3
PA4.Signal=ADC_IN4
PA5.Signal=ADC_IN5
PA6.Signal=ADC_IN6
PA7.Signal=ADC_IN7
PA8.Signal=USART1_CK
PA9.Signal=USART1_TX
PB0.Signal=ADC_IN8
PB1.Signal=ADC_IN9
PB10.GPIO_Label=SW4
PB10.Signal=GPIO_Input
PB11.GPIO_Label=SW5
PB11.Signal=GPIO_Input
PB12.GPIO_Label=SS2
PB12.Signal=GPIO_Output
PB13.Signal=SPI2_SCK
PB14.Signal=SPI2_MISO
PB15.Signal=SPI2_MOSI
PB2.GPIO_Label=SW2
PB2.Signal=GPIO_Input
PB3.Signal=SPI1_SCK
PB4.GPIO_Label=SS1
PB4.Signal=GPIO_Output
PB5.Signal=SPI1_MOSI
PB6.GPIO_Label=POT RST
PB6.Signal=GPIO_Input
PB7.GPIO_Label=POT SHDN
PB7.Signal=GPIO_Input
PB8.GPIO_Label=BOOT0
PB8.Signal=GPIO_Input
PB9.GPIO_Label=SW0
PB9.Signal=GPIO_Input
PC13.GPIO_Label=SW1
PC13.Signal=GPIO_Input
PC14OSC32_IN.GPIO_Label=SW2
PC14OSC32_IN.Signal=GPIO_Input
PC15OSC32_OUT.GPIO_Label=LED
PC15OSC32_OUT.Signal=GPIO_Output
PF0-OSC_IN.Signal=RCC_OSC_IN
PF1-OSC_OUT.Signal=RCC_OSC_OUT
