k0201/TiN_Anaalog_sensor_emulation/(commit log)

2019-05-17 stworzenie projektu, dodanie potencjometrów cyfrowych
    [TiN_analog_sensor_emulation.kicad_pcb, TiN_analog_sensor_emulation.sch, digital_pot.sch, mcu.sch, screen.sch]
2019-05-17 Praca nad sch, dodana sekcja zasilania i karta sd
    [TiN_analog_sensor_emulation.sch, digital_pot.sch, mcu.sch, power.sch, screen.sch]
2019-05-17 dalsza praca nad sch, przypisanie pinów
    [TiN_analog_sensor_emulation.sch, digital_pot.sch, mcu.sch, power.sch, screen.sch]
2019-05-17 przeniosiono do folderu hardware
    [TiN_analog_sensor_emulation.kicad_pcb, TiN_analog_sensor_emulation.sch, digital_pot.sch, mcu.sch, power.sch, screen.sch]
2019-05-18 dodano wyjscie programatora, przyciski ustalono wysjcie i2c, dodany plik CubeMX z pinouterm
    [TiN_analog_sensor_emulation.sch, digital_pot.sch, mcu.sch, screen.sch]
2019-05-18 DRC przechodzi dorzucone złącze do wyświetlacza na i2c oraz jeden push button
    [TiN_analog_sensor_emulation.sch, digital_pot.sch, mcu.sch, power.sch]
2019-05-18 przypisano footprinty
    [TiN_analog_sensor_emulation.sch, digital_pot.sch, mcu.sch, power.sch]
2019-05-18 Dodenie pullup do spi i i2c
    [digital_pot.sch, mcu.sch, power.sch]
2019-05-18 pierwszy układ PCB
    [digital_pot.sch, mcu.sch, power.sch]
2019-05-19 update pinoutu, zmiany footprintów
    [TiN_analog_sensor_emulation.kicad_pcb, mcu.sch, power.sch]
2019-05-19 dodanie zabezpieczen portów i dzialniki napiec na wejsciach adc
    [TiN_analog_sensor_emulation.kicad_pcb, digital_pot.sch, mcu.sch, power.sch]
2019-05-19 mała poprawka przy kondensatorach od opampow
    [TiN_analog_sensor_emulation.kicad_pcb, digital_pot.sch]
2019-05-19 trwa układanie, dodane złacze golpin
    [TiN_analog_sensor_emulation.kicad_pcb, digital_pot.sch, mcu.sch]
2019-05-19 layout gotów, do wyeliminowania błedy DRC
    [TiN_analog_sensor_emulation.kicad_pcb, digital_pot.sch, mcu.sch, power.sch]
2019-05-19 dodany otwór do montażu wyświetlacza
    [TiN_analog_sensor_emulation.kicad_pcb, TiN_analog_sensor_emulation.sch]
2019-05-20 update top overlay, drc przechodzi, dodny shielding wokół ścieżek zegarowych, dodane zdjęcia płytki
    [TiN_analog_sensor_emulation.kicad_pcb, power.sch]
2019-05-20 drobne poprawki w przelotkach
    [TiN_analog_sensor_emulation.kicad_pcb]
2019-05-24 dodano gerbery i obrócono kartę uSD (teraz na bottom)
    [TiN_analog_sensor_emulation-B_Cu.gbr, TiN_analog_sensor_emulation-B_Mask.gbr, TiN_analog_sensor_emulation-B_Paste.gbr, TiN_analog_sensor_emulation-B_SilkS.gbr, TiN_analog_sensor_emulation-Edge_Cuts.gbr, TiN_analog_sensor_emulation-F_Cu.gbr, TiN_analog_sensor_emulation-F_Mask.gbr, TiN_analog_sensor_emulation-F_Paste.gbr]
2019-06-15 dodano poprawki błędów znalezionych podczas montażu
    [TiN_analog_sensor_emulation.kicad_pcb, mcu.sch, power.sch]
2019-06-26 dodanie PDF schematu
    [TiN_analog_sensor_emulation.kicad_pcb]
